JonathanBedrava/eurorack-cv-led-strip-controller/(list of files, drawings)

Other design files:
kicad/LedController1.dsn
