JonathanBedrava/eurorack-cv-led-strip-controller/kicad/LedController1.kicad_pcb

## KiCad design kicad/LedController1.kicad_pcb (2022-02-23)

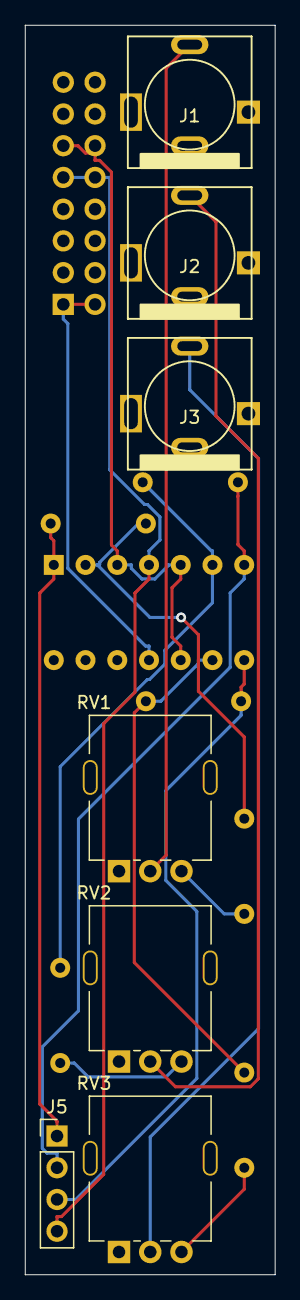
[picture p1: board LedController1.kicad_pcb from above]

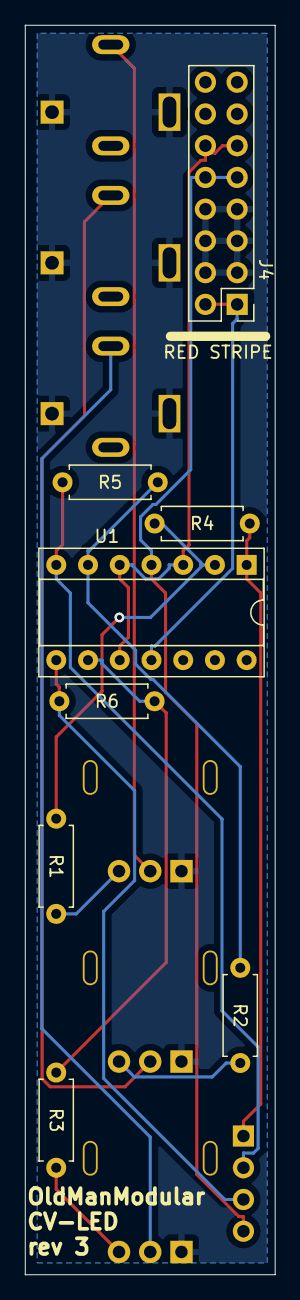
[picture p2: board LedController1.kicad_pcb from below]

Board: 2 copper layers, 20.0 x 100.0 mm, 15 parts (8 on the bottom side), 16 nets.

Parts:
J1, J2, J3: AudioJack2; PJ301BM
J4: Conn_02x08_Odd_Even; PinHeader_2x08_P2.54mm_Vertical
J5: Conn_01x04_Female; PinHeader_1x04_P2.54mm_Vertical
R1, R2, R3: 10K; R_Axial_DIN0207_L6.3mm_D2.5mm_P7.62mm_Horizontal
R4, R5, R6: 22K; R_Axial_DIN0207_L6.3mm_D2.5mm_P7.62mm_Horizontal
RV1, RV2, RV3: 100K; Potentiometer_Alpha_Single_Vertical
U1: TL084; DIP-14_W7.62mm_Socket

Connections:
+5V: J4.11, J4.12, U1.3 (+), U1.5 (+), U1.10 (+)
+12V: J4.9, J4.10, J5.4, U1.4 (V+)
-12V: J4.1, J4.2, U1.11 (V-)
/InputSignal/Signal: R1.2, RV1.3
/sheet5FE67A34/Signal: R3.2, RV3.3
/sheet5FE679DC/Signal: R2.2, RV2.3
GND: J1.S, J2.S, J3.S, J4.3, J4.4, J4.5, J4.6, J4.7, J4.8, RV1.1, RV2.1, RV3.1
unnamed: J1.T, RV1.2
unnamed: J2.T, RV2.2
unnamed: J3.T, RV3.2
unnamed: J5.1, R4.2, U1.1
unnamed: J5.2, R5.2, U1.7
unnamed: J5.3, R6.2, U1.8
unnamed: R1.1, R4.1, U1.2 (-)
unnamed: R2.1, R5.1, U1.6 (-)
unnamed: R3.1, R6.1, U1.9 (-)
