JonathanBedrava/eurorack-cv-led-strip-controller/(commit log)

2021-01-08 Adding kicad project
    [InputSignal.sch, LedController1.sch]
2021-01-08 Changing dir structure
    [InputSignal.sch, LedController1.sch]
2021-07-04 Adding plots for JLCPCB
    [LedController1-B_Cu.gbr, LedController1-B_Mask.gbr, LedController1-B_SilkS.gbr, LedController1-Edge_Cuts.gbr, LedController1-F_Cu.gbr, LedController1-F_Mask.gbr, LedController1-F_SilkS.gbr, LedController1-bottom-pos.csv]
2021-07-04 Renaming folder
    [LedController1-B_Cu.gbr, LedController1-B_Mask.gbr, LedController1-B_SilkS.gbr, LedController1-Edge_Cuts.gbr, LedController1-F_Cu.gbr, LedController1-F_Mask.gbr, LedController1-F_SilkS.gbr, LedController1-bottom-pos.csv]
2021-07-04 Renaming plots forlder for 3x version
    [LedController1-B_Cu.gbr, LedController1-B_Mask.gbr, LedController1-B_SilkS.gbr, LedController1-Edge_Cuts.gbr, LedController1-F_Cu.gbr, LedController1-F_Mask.gbr, LedController1-F_SilkS.gbr, LedController1-bottom-pos.csv]
2022-02-23 Correcting PJ301BM footprint
    [InputSignal.kicad_sch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]
